JacobLEdwards/wifi-data-logger/Data-Logger/Data-Logger.pdf

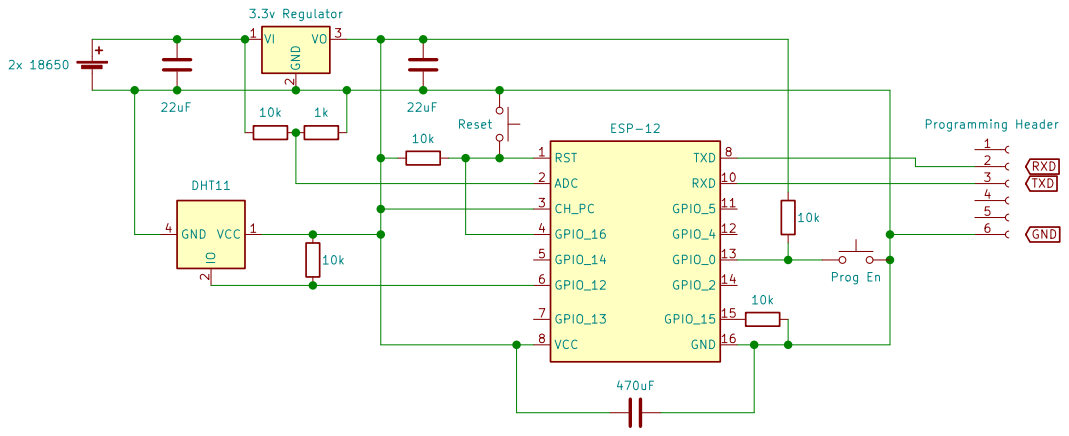
[picture p1: page 1]
