JacobLEdwards/wifi-data-logger/ESP-Programmer/ESP-Programmer.pdf

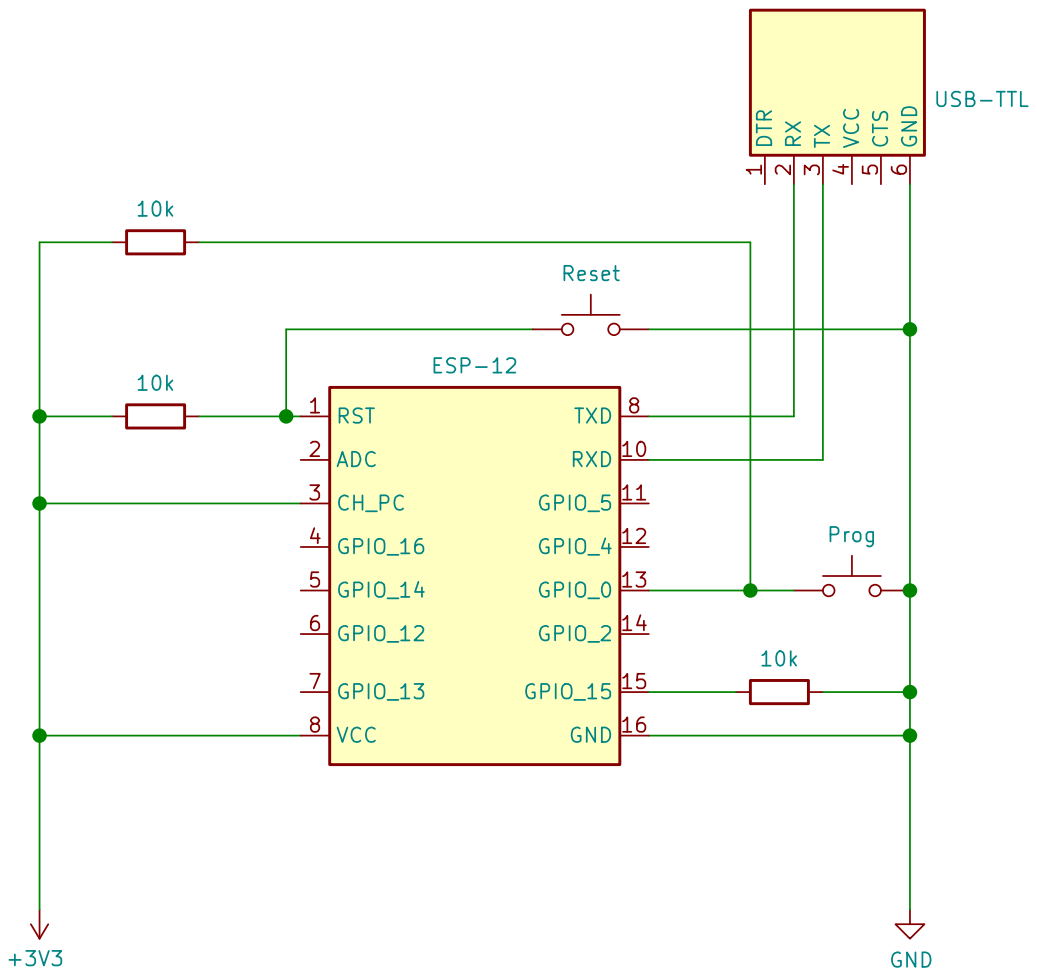
[picture p2: page 1]
