JacobLEdwards/wifi-data-logger/(commit log)

2019-08-05 Added Programmer Schematic
2019-08-10 Temperature Reading & Testing
2019-08-10 Full Functionality Test, and Final Schematic
